rdpoor/PiezoPhone/README.md

# PiezoPhone
Arduino-based Digital Marimba / Xylophone / Glockenspiel
