rdpoor/PiezoPhone/PiezoPhone/Project_Libraries/SJ1-3525NG_CUD/SJ1-3525NG.STEP

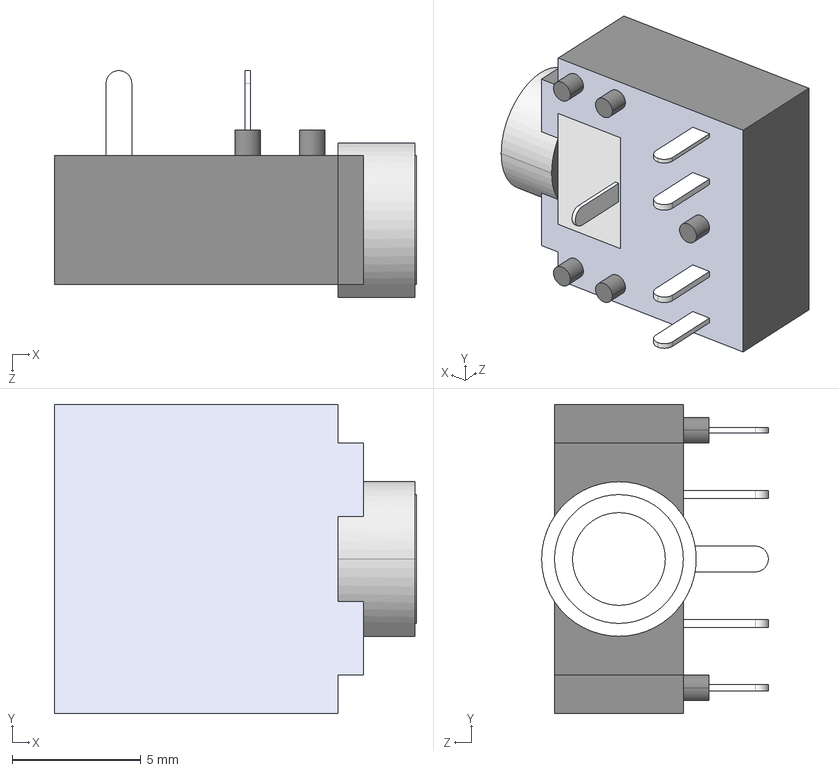
[picture p1: CAD file, 2026-07-24]
PiezoPhone/Project_Libraries/SJ1-3525NG_CUD/SJ1-3525NG.STEP
14.0 x 12.0 x 8.80 mm
