rdpoor/PiezoPhone/(list of files, drawings)

Other design files:
PiezoPhone/Project_Libraries/ABX00142-cad-files/ABX00142-cad-files/PCB.PcbDoc
PiezoPhone/Project_Libraries/ABX00142-cad-files/ABX00142-cad-files/TOP.SchDoc
