rdpoor/PiezoPhone/PiezoPhone/_restore_backup_2026-07-01T14-12-37-191/PiezoPhone.kicad_pcb

## KiCad design PiezoPhone/_restore_backup_2026-07-01T14-12-37-191/PiezoPhone.kicad_pcb (2026-07-24)

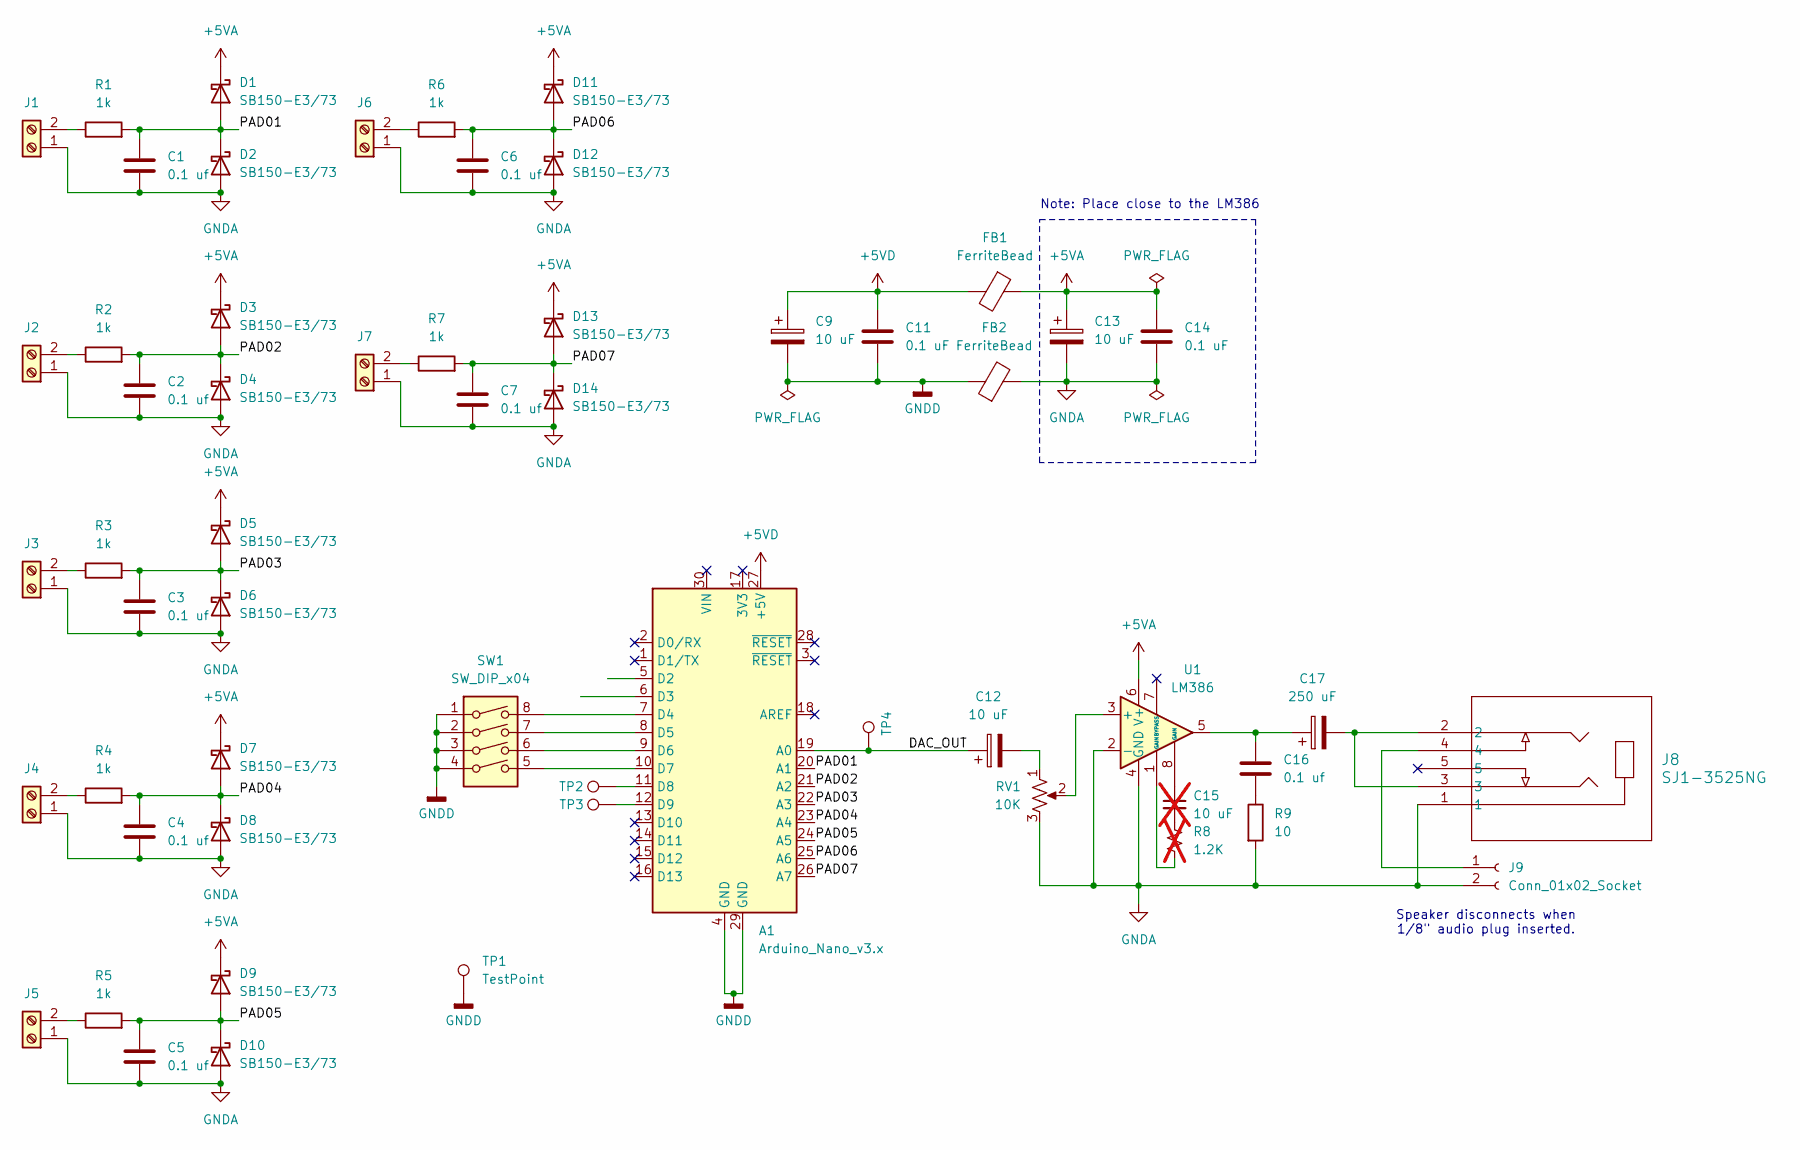
[picture p2: schematic PiezoPhone.kicad_sch]

Parts:
A1: Arduino_Nano_v3.x; Arduino_Nano
C1, C2, C3, C4, C5, C6, C7, C16: 0.1 uf; C_Disc_D4.7mm_W2.5mm_P5.00mm
C9, C12, C13: 10 uF; CP_Radial_D5.0mm_P2.50mm
C11, C14: 0.1 uF; C_Disc_D4.7mm_W2.5mm_P5.00mm
C15: 10 uF; CP_Radial_D5.0mm_P2.50mm; not fitted
C17: 250 uF; CP_Radial_D8.0mm_P3.50mm
D1, D2, D3, D4, D5, D6, D7, D8, D9, D10, D11, D12, D13, D14: SB150-E3/73; D_DO-41_SOD81_P10.16mm_Horizontal
FB1, FB2: FerriteBead; R_Axial_DIN0411_L9.9mm_D3.6mm_P12.70mm_Horizontal
J1, J2, J3, J4, J5, J6, J7: Screw_Terminal_01x02; PhoenixContact_MSTBVA_2,5_2-G_1x02_P5.00mm_Vertical
J8: SJ1-3525NG; SJ1-3525NG_CUD
J9: Conn_01x02_Socket; JST_PH_S2B-PH-K_1x02_P2.00mm_Horizontal
R1, R2, R3, R4, R5, R6, R7: 1k; R_Axial_DIN0207_L6.3mm_D2.5mm_P15.24mm_Horizontal
R8: 1.2K; R_Axial_DIN0207_L6.3mm_D2.5mm_P15.24mm_Horizontal; not fitted
R9: 10; R_Axial_DIN0207_L6.3mm_D2.5mm_P15.24mm_Horizontal
RV1: 10K; TRIM_3352T-1-103LF
SW1: SW_DIP_x04; DIP-8_W7.62mm_Socket
TP1, TP2, TP3, TP4: TestPoint; TestPoint_Keystone_5005-5009_Compact
U1: LM386; DIP-8_W7.62mm_Socket_LongPads

Connections:
+5VA: C13.1, C14.1, D1.1 (K), D3.1 (K), D5.1 (K), D7.1 (K), D9.1 (K), D11.1 (K), D13.1 (K), FB1.1, U1.6 (V+)
+5VD: A1.27 (+5V), C9.1, C11.1, FB1.2
/DAC_OUT: A1.19 (A0), C12.1, TP4.1 (1_1)
/PAD01: A1.20 (A1), C1.1, D1.2 (A), D2.1 (K), R1.2
/PAD02: A1.21 (A2), C2.1, D3.2 (A), D4.1 (K), R2.2
/PAD03: A1.22 (A3), C3.1, D5.2 (A), D6.1 (K), R3.2
/PAD04: A1.23 (A4), C4.1, D7.2 (A), D8.1 (K), R4.2
/PAD05: A1.24 (A5), C5.1, D9.2 (A), D10.1 (K), R5.2
/PAD06: A1.25 (A6), C6.1, D11.2 (A), D12.1 (K), R6.2
/PAD07: A1.26 (A7), C7.1, D13.2 (A), D14.1 (K), R7.2
GNDA: C1.2, C2.2, C3.2, C4.2, C5.2, C6.2, C7.2, C13.2, C14.2, D2.2 (A), D4.2 (A), D6.2 (A), D8.2 (A), D10.2 (A), D12.2 (A), D14.2 (A), FB2.2, J1.1, J2.1, J3.1, J4.1, J5.1, J6.1, J7.1, J8.1, J9.2, R9.2, RV1.3, U1.2 (-), U1.4 (GND)
GNDD: A1.4 (GND), A1.29 (GND), C9.2, C11.2, FB2.1, SW1.1, SW1.2, SW1.3, SW1.4, TP1.1 (1_1)
unnamed: A1.7 (D4), SW1.8
unnamed: A1.8 (D5), SW1.7
unnamed: A1.9 (D6), SW1.6
unnamed: A1.10 (D7), SW1.5
unnamed: A1.11 (D8), TP2.1 (1_1)
unnamed: A1.12 (D9), TP3.1 (1_1)
unnamed: C12.2, RV1.1
unnamed: C15.1, U1.8 (GAIN)
unnamed: C15.2, R8.1
unnamed: C16.1, C17.1, U1.5
unnamed: C16.2, R9.1
unnamed: C17.2, J8.2, J8.3
unnamed: J1.2, R1.1
unnamed: J2.2, R2.1
unnamed: J3.2, R3.1
unnamed: J4.2, R4.1
unnamed: J5.2, R5.1
unnamed: J6.2, R6.1
unnamed: J7.2, R7.1
unnamed: J8.4, J9.1
unnamed: R8.2, U1.1 (GAIN)
unnamed: RV1.2, U1.3 (+)

Notes on the sheet:
Speaker disconnects when 1/8" audio plug inserted.
Note: Place close to the LM386

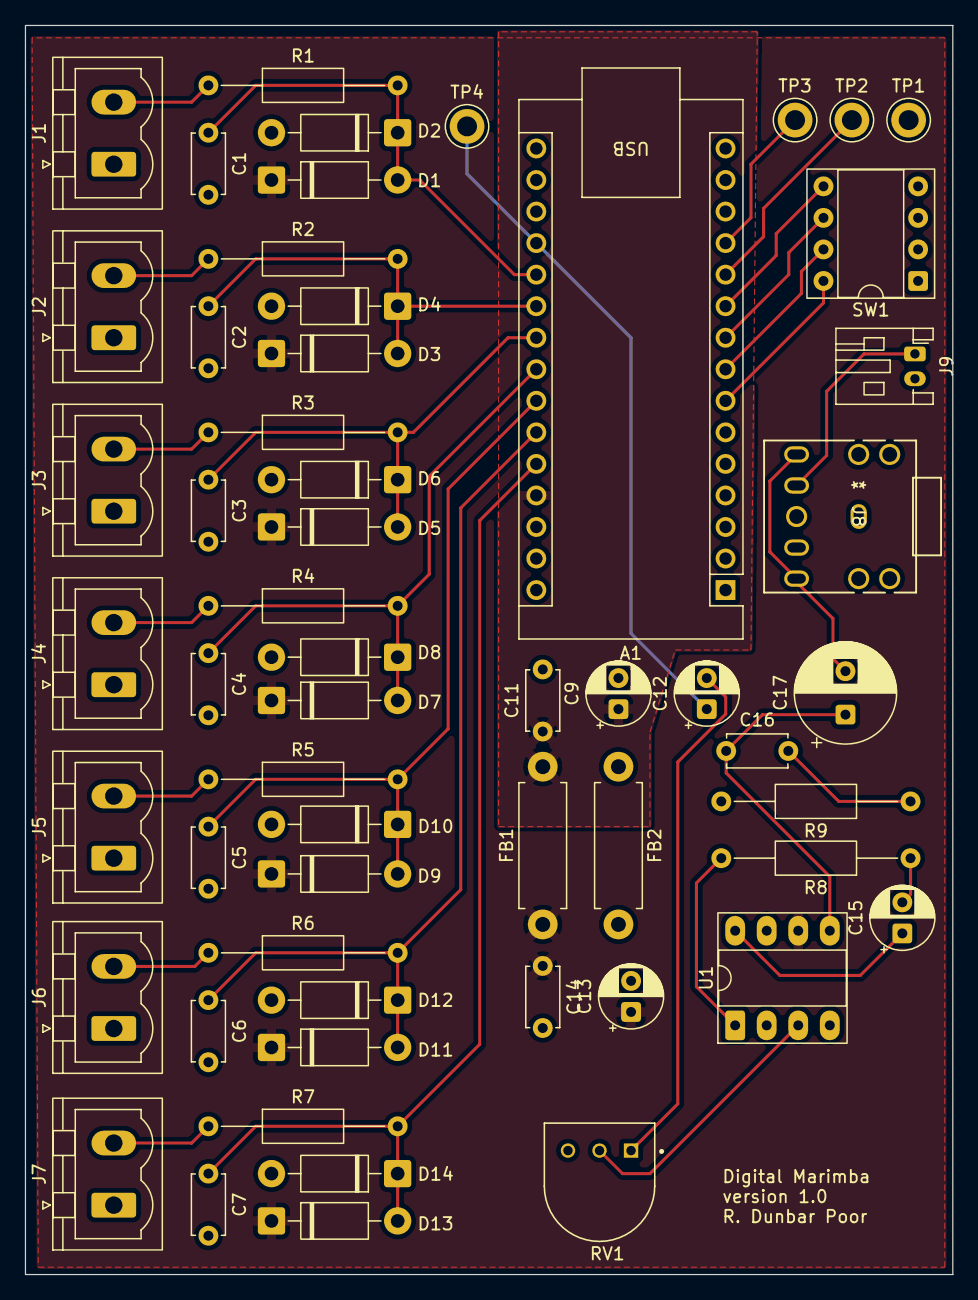
[picture p3: board PiezoPhone.kicad_pcb from above]

Board: 2 copper layers, 74.7 x 100.6 mm, 57 parts (0 on the bottom side), 34 nets.
