rdpoor/PiezoPhone/(commit log)

2026-05-29 Initial schematic and footprints
    [ANT11SF1CQE.stp, PCB.PcbDoc, PiezoPhone.kicad_pcb, PiezoPhone.kicad_sch, SB150-E3_73.step, TB002-500-02BE.step, TOP.SchDoc, WCAP-ATG5_5X11.step]
2026-06-12 adding footprints
2026-06-12 Consolidate downloaded EDA parts into a single project library
    Merge all UltraLibrarian/SnapMagic symbols, footprints, and 3D models
    into one project-local library registered via ${KIPRJMOD}:
    - PiezoPhone.kicad_sym (19 symbols), PiezoPhone.pretty (18 footprints),
    PiezoPhone.3dshapes (STEP + Wurth WRL)
    - Rewrite every symbol Footprint property to PiezoPhone:<footprint>
    - Add 3D model refs to SnapMagic footprints; repoint Wurth ferrite
    models from ${WE_3DMODEL_DIR} to ${KIPRJMOD}/PiezoPhone.3dshapes
    - Fix fp-lib-table/sym-lib-table; drop broken/placeholder entries
    - Fold in the existing Ferrite_THT_Wurth set; drop redundant SnapMagic
    7427603 duplicate; dedupe shared LR1 resistor footprin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
2026-07-24 Update PCB v1.1
    [PiezoPhone-B_Cu.gbl, PiezoPhone-B_Mask.gbs, PiezoPhone-B_Paste.gbp, PiezoPhone-B_Silkscreen.gbo, PiezoPhone-Edge_Cuts.gm1, PiezoPhone-F_Cu.gtl, PiezoPhone-F_Mask.gts, PiezoPhone-F_Paste.gtp]
2026-07-24 Add DigitalXylophone Arduino code and gen_tones.py
2026-07-25 debugging input stage
